ryood/Mixer/(list of files, cad)

Other CAD files:
case/Mixer-Case.dwg
