ryood/Mixer/eagle/Virtual-Ground.brd

## EAGLE design eagle/Virtual-Ground.brd (2014-09-16)

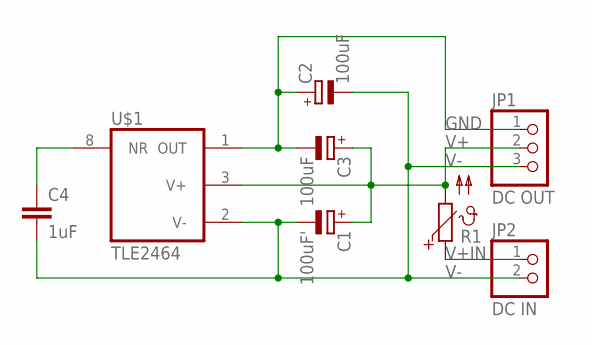
[picture p1: schematic Virtual-Ground.sch]

Parts:
C1: 100uF'; E2,5-6
C2, C3: 100uF; E2,5-6
C4: 1uF; C050-050X075
JP1: DC OUT; 1X03
JP2: DC IN; 1X02
R1: PTC660; P660
U$1: TLE2464

Connections:
GND: C2.+, C3.-, JP1.1, U$1.1 (OUT)
unnamed: C4.1, U$1.8 (NR)
V+: C1.+, C3.+, JP1.2, R1.2, U$1.3 (V+)
V+IN: JP2.1, R1.1
V-: C1.-, C2.-, C4.2, JP1.3, JP2.2, U$1.2 (V-)

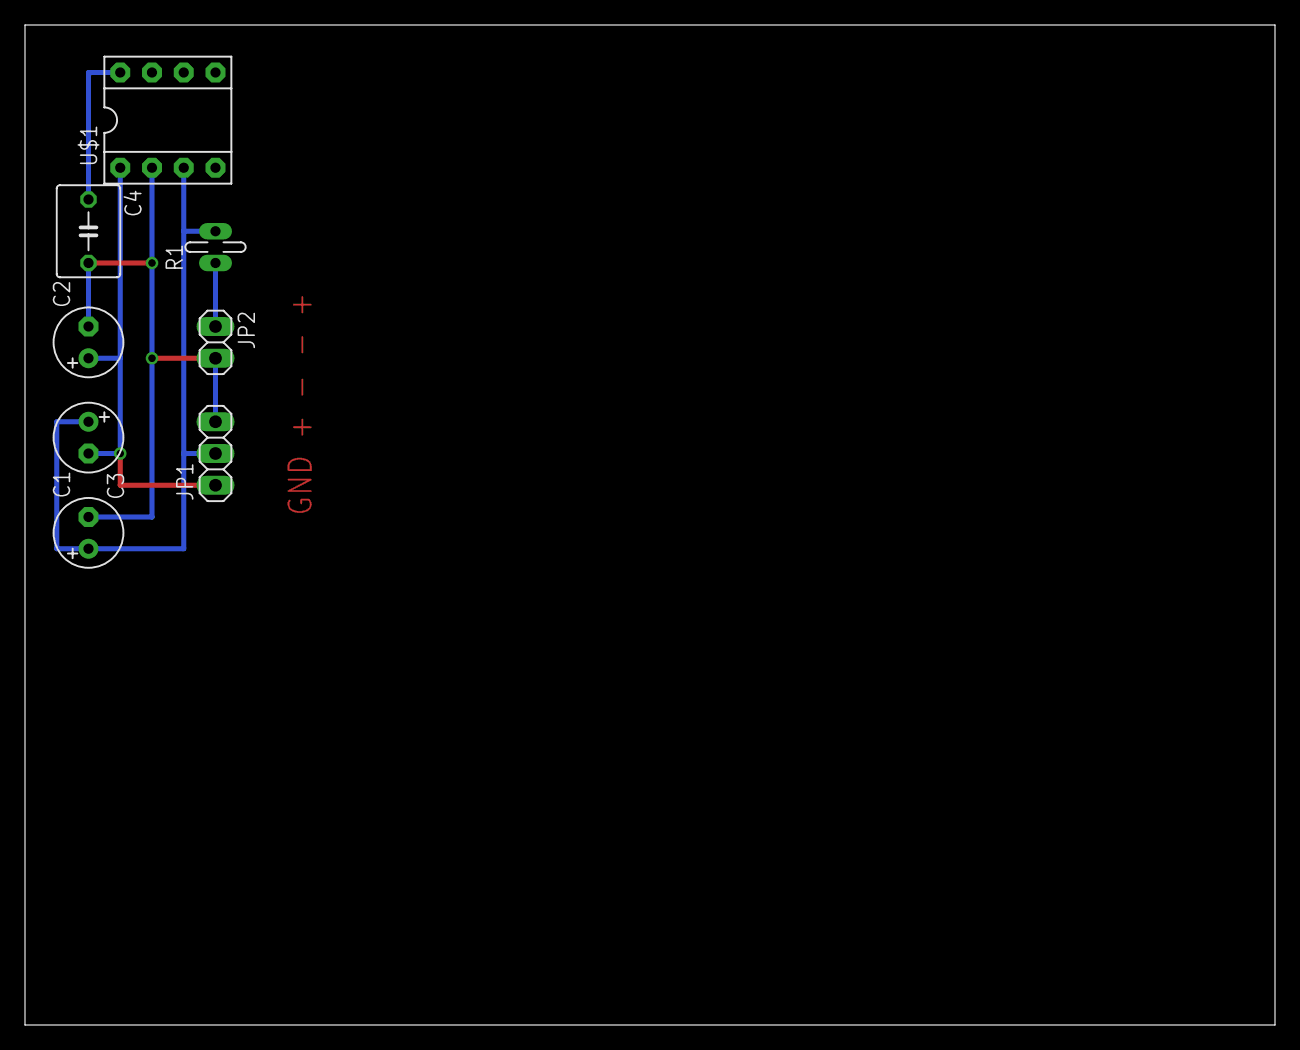
[picture p2: board Virtual-Ground.brd from above]

Board: 2 copper layers, 100.0 x 80.0 mm, 8 parts (0 on the bottom side), 5 nets.
