ryood/Mixer/eagle/Mixer-01.brd

## EAGLE design eagle/Mixer-01.brd (2014-09-14)

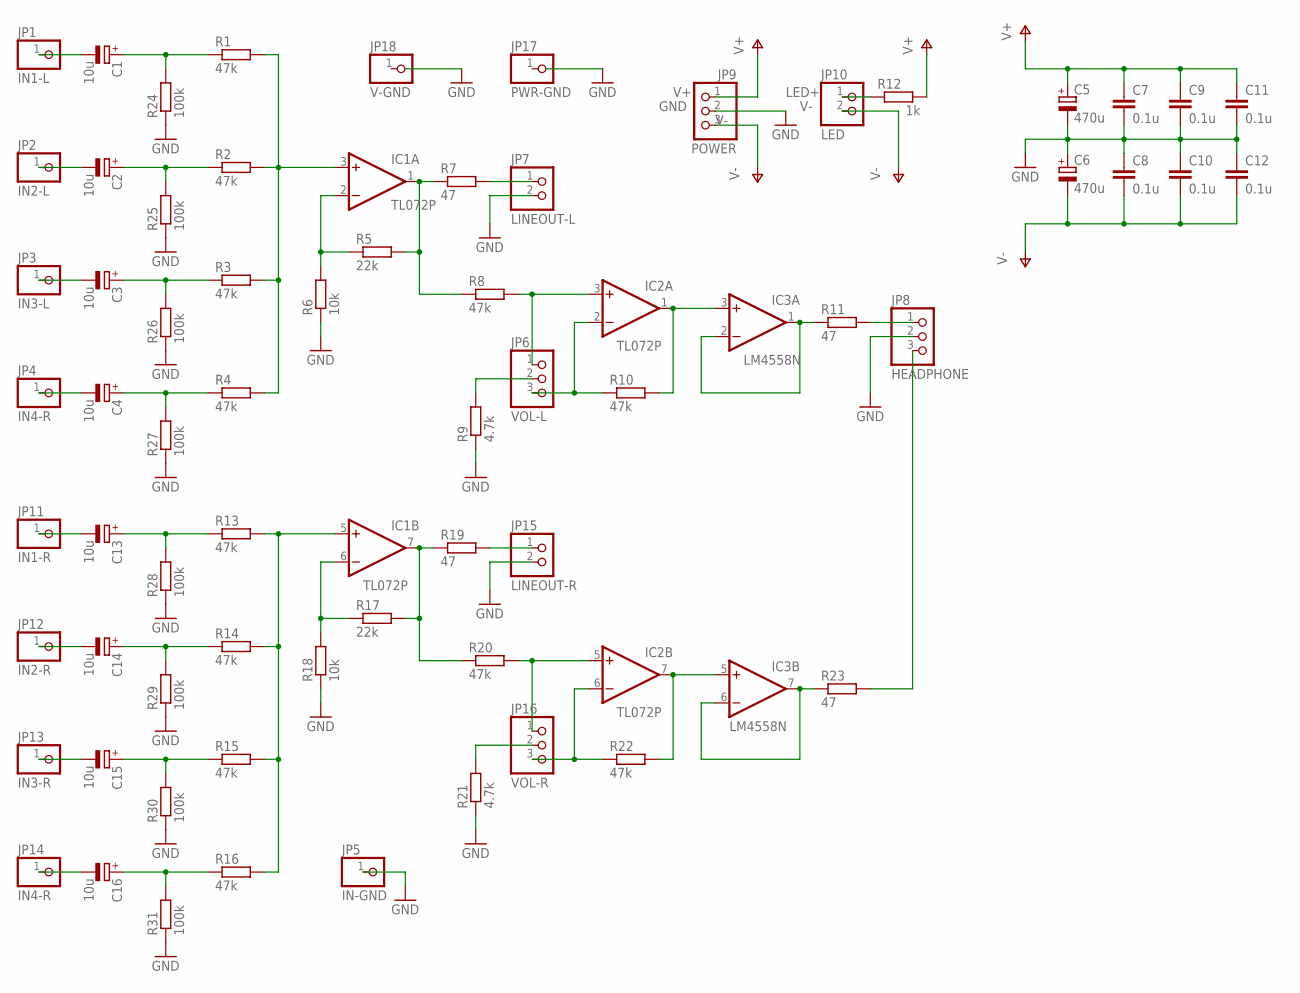
[picture p3: schematic Mixer-01.sch]

Parts:
C1, C2, C3, C4, C13, C14, C15, C16: 10u; E5-8,5
C5, C6: 470u; E7,5-16
C7, C8, C9, C10, C11, C12: 0.1u; C050-024X044
IC1, IC2: TL072P; DIL08
IC3: LM4558N; DIL08
JP1: IN1-L; 1X01
JP2: IN2-L; 1X01
JP3: IN3-L; 1X01
JP4, JP14: IN4-R; 1X01
JP5: IN-GND; 1X01
JP6: VOL-L; 1X03
JP7: LINEOUT-L; 1X02
JP8: HEADPHONE; 1X03
JP9: POWER; 1X03
JP10: LED; 1X02
JP11: IN1-R; 1X01
JP12: IN2-R; 1X01
JP13: IN3-R; 1X01
JP15: LINEOUT-R; 1X02
JP16: VOL-R; 1X03
JP17: PWR-GND; 1X01
JP18: V-GND; 1X01
R1, R2, R3, R4, R8, R10, R13, R14, R15, R16, R20, R22: 47k; 0207/7
R5, R17: 22k; 0207/7
R6, R18: 10k; 0207/7
R7, R11, R19, R23: 47; 0207/7
R9, R21: 4.7k; 0207/7
R12: 1k; 0207/7
R24, R25, R26, R27, R28, R29, R30, R31: 100k; 0207/7

Connections:
GND: C5.-, C6.+, C7.2, C8.1, C9.2, C10.1, C11.2, C12.1, JP5.1, JP7.2, JP8.2, JP9.2, JP15.2, R6.1, R9.1, R18.1, R21.1, R24.1, R25.1, R26.1, R27.1, R28.1, R29.1, R30.1, R31.1
LED+: JP10.1, R12.1
unnamed: C1.-, JP1.1
unnamed: C2.-, JP2.1
unnamed: C3.-, JP3.1
unnamed: C4.-, JP4.1
unnamed: JP6.2, R9.2
unnamed: C13.+, R13.1, R28.2
unnamed: C14.+, R14.1, R29.2
unnamed: C1.+, R1.1, R24.2
unnamed: C2.+, R2.1, R25.2
unnamed: C3.+, R3.1, R26.2
unnamed: C4.+, R4.1, R27.2
unnamed: IC1.3 (+IN), R1.2, R2.2, R3.2, R4.2
unnamed: IC1.2 (-IN), R5.1, R6.2
unnamed: IC1.1 (OUT), R5.2, R7.1, R8.1
unnamed: JP7.1, R7.2
unnamed: IC2.3 (+IN), JP6.1, R8.2
unnamed: C15.+, R15.1, R30.2
unnamed: IC2.2 (-IN), JP6.3, R10.1
unnamed: IC2.1 (OUT), IC3.3 (+IN), R10.2
unnamed: IC3.1 (OUT), IC3.2 (-IN), R11.1
unnamed: JP8.1, R11.2
unnamed: C16.+, R16.1, R31.2
unnamed: IC1.5 (+IN), R13.2, R14.2, R15.2, R16.2
unnamed: IC1.6 (-IN), R17.1, R18.2
unnamed: IC1.7 (OUT), R17.2, R19.1, R20.1
unnamed: JP15.1, R19.2
unnamed: IC2.5 (+IN), JP16.1, R20.2
unnamed: IC2.6 (-IN), JP16.3, R22.1
unnamed: IC2.7 (OUT), IC3.5 (+IN), R22.2
unnamed: IC3.6 (-IN), IC3.7 (OUT), R23.1
unnamed: JP8.3, R23.2
unnamed: C13.-, JP11.1
unnamed: C14.-, JP12.1
unnamed: C15.-, JP13.1
unnamed: C16.-, JP14.1
unnamed: JP16.2, R21.2
V+: C5.+, C7.1, C9.1, C11.1, IC1.8 (V+), IC2.8 (V+), IC3.8 (V+), JP9.1, R12.2
V-: C6.-, C8.2, C10.2, C12.2, IC1.4 (V-), IC2.4 (V-), IC3.4 (V-), JP9.3, JP10.2

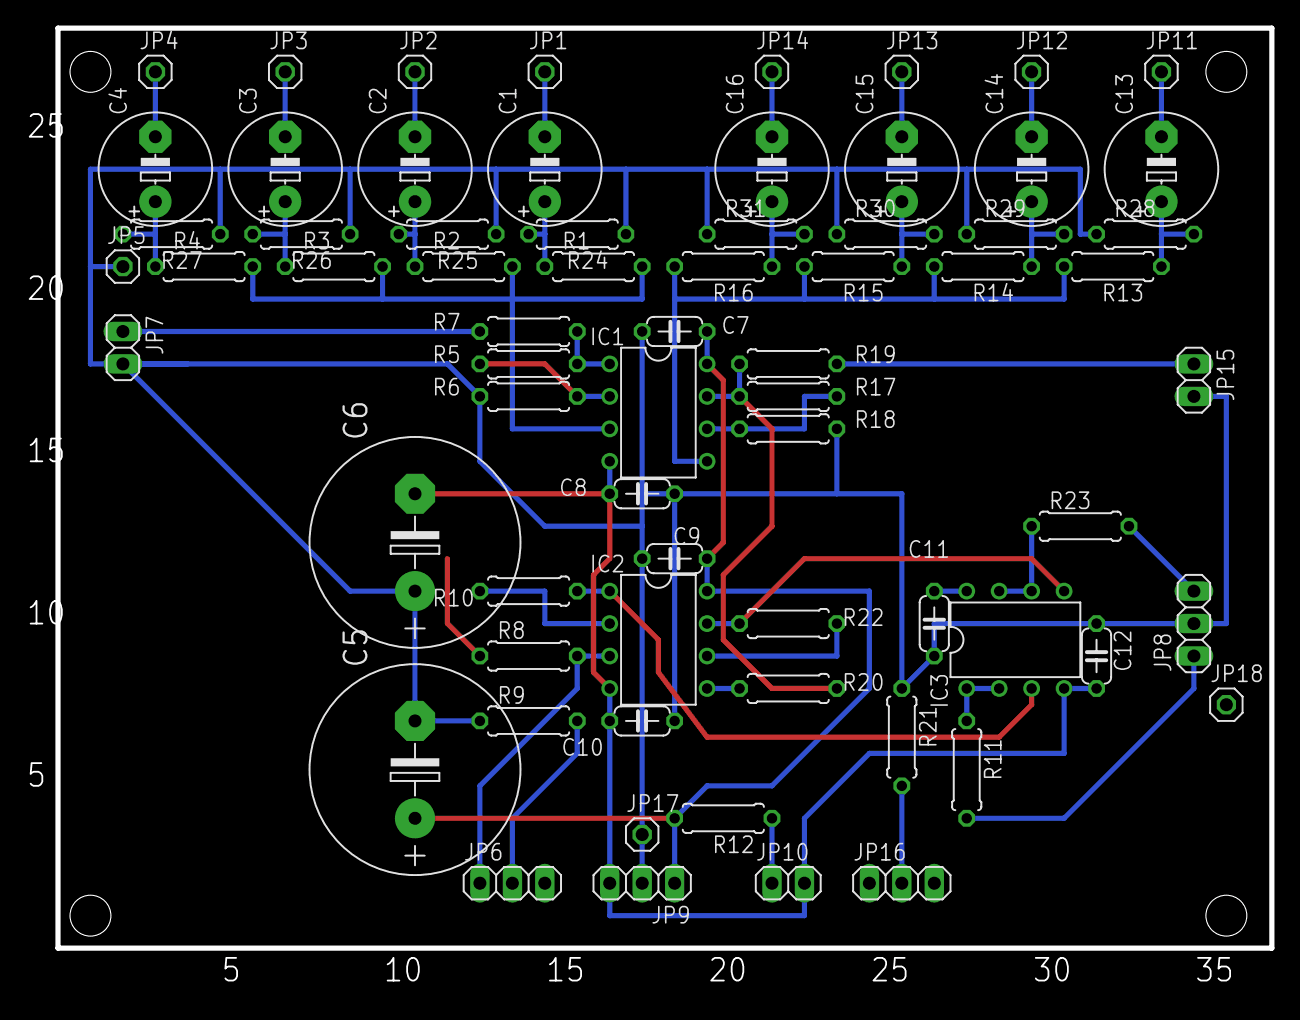
[picture p4: board Mixer-01.brd from above]

Board: 2 copper layers, 95.0 x 72.0 mm, 68 parts (0 on the bottom side), 40 nets.
