ryood/Mixer/TestChart.xlsx

Mixer テスト項目表
1. 電源なし
 | Point1 | Point2 | Check | 2014.07.09テスト | 2014.07.11テスト
1 | R1 | IC1 Pin3 | 47kΩ | 46.9k | ←
2 | R2 | IC1 Pin3 | 47kΩ | 47.0k | ←
3 | R3 | IC1 Pin3 | 47kΩ | 46.9k | ←
4 | R4 | IC1 Pin3 | 47kΩ | 47.0k | ←
5 | R13 | IC1 Pin5 | 47kΩ | 47.0k | ←
6 | R14 | IC1 Pin5 | 47kΩ | 47.1k | ←
7 | R15 | IC1 Pin5 | 47kΩ | 47.0k | ←
8 | R16 | IC1 Pin5 | 47kΩ | 47.0k | ←
9 | IN-GND | GND | 疎通 | ok | ←
10 | IC1 Pin2 | GND | 10kΩ | 10.01k | 10.02k
11 | IC1 Pin2 | IC1 Pin1 | 22kΩ | 21.7k | ←
12 | IC1 Pin1 | LINEOUT-L Pin1 | 47Ω | 47.2 | 47.0
13 | IC1 Pin1 | IC2 Pin3 | 47kΩ | 46.9k | ←
14 | LINEOUT-L Pin2 | GND | 疎通 | ok | ←
15 | IC2 Pin3 | VOL-L Pin1 | 疎通 | ok | ←
16 | IC2 Pin2 | VOL-L Pin3 | 疎通 | ok | ←
17 | VOL-L Pin2 | GND | 4.7kΩ | 4.68k | ←
18 | IC2 Pin1 | IC2 Pin2 | 47kΩ | 46.9k | ←
19 | IC2 Pin2 | VOL-L Pin3 | 疎通 | ok | ←
20 | IC2 Pin1 | IC3 Pin3 | 疎通 | ok | ←
21 | IC3 Pin2 | IC3 Pin1 | 疎通 | ok | ←
22 | IC１ Pin1 | HEADPHONE Pin1 | 47Ω | 47.3 | ←
23 | HEADPHONE Pin2 | GND | 疎通 | ok | ←
24 | IC1 Pin6 | GND | 10kΩ | 10.01k | ←
25 | IC1 Pin6 | IC1 Pin7 | 22kΩ | 21.8k | ←
26 | IC1 Pin7 | IC2 Pin5 | 47kΩ | 46.9k | ←
27 | IC1 Pin7 | LINEOUT-R Pin1 | 47Ω | 47.2 | 47.0
28 | LINEOUT-R Pin2 | GND | 疎通 | ok | ←
29 | IC2 Pin5 | VOL-R Pin1 | 疎通 | ok | ←
30 | IC2 Pin6 | VOL-R Pin3 | 疎通 | ok | ←
31 | VOL-R Pin2 | GND | 4.7kΩ | 4.7k | ←
32 | IC2 Pin6 | IC2 Pin7 | 47kΩ | 47.2k | ←
33 | IC2 Pin7 | IC3 Pin5 | 疎通 | ok | ←
34 | IC2 Pin6 | IC2 Pin7 | 47kΩ | 47.2k | ←
35 | IC2 Pin7 | IC3 Pin5 | 疎通 | ok | ←
36 | IC3 Pin6 | IC3 Pin7 | 疎通 | ok | ←
37 | IC3 Pin7 | HEADPHONE Pin3 | 47Ω | 47.2 | 47.3
38 | POWER Pin1 | IC1 Pin8 | 疎通 | ok | ←
39 | POWER Pin1 | IC2 Pin8 | 疎通 | ok | ←
40 | POWER Pin1 | IC3 Pin8 | 疎通 | NG | ok
41 | POWER Pin1 | LED Pin1 | 1kΩ | 994 | ←
42 | POWER Pin2 | GND | 疎通 | ? | ok
43 | POWER Pin3 | IC1 Pin4 | 疎通 | ok | ←
44 | POWER Pin3 | IC2 Pin4 | 疎通 | ok | ←
45 | POWER Pin3 | IC3 Pin4 | 疎通 | ok | ←
46 | POWER Pin3 | LED Pin2 | 疎通 | ok | ←
47 | PWR-GND | GND | 疎通 |  | ok
2.電源 -4.5V - 0V - +4.5V
 | Point1 | Point2 | Check | 2014.07.11 | 2014.07.18
1 | IC1 Pin4 | GND | -4.5V | -4.34 | -3.97
2 | IC1 Pin8 | GND | +4.5V | 4.47 | 4.22
3 | IC2 Pin4 | GND | -4.5V | -4.34 | -3.97
4 | IC2 Pin8 | GND | +4.5V | 4.47 | 4.22
5 | IC3 Pin4 | GND | -4.5V | -4.34 | -3.97
6 | IC3 Pin8 | GND | +4.5V | 4.47 | 4.22
7 | LED Pin1 | GND | +4.5V | 4.47 | 4.22
8 | LED Pin2 | GND | -4.5V | -4.34 | -3.97
3.電源 In1 0.45V Sine 1kHz
 | Point1 | Point2 | Check | 2014.07.13 | 2014.07.23
1 | V+ |  | 500uA | 12.28mA | 11mA to 37mA ※1
2 | V- |  | -500uA | -11.80mA | 12mA to 35mA ※1
3 | R1 | GND | DC 0V AC 0.45V | 1.26 0.35
4 | R13 | GND | DC 0V AC 0.45V | 2.36 0.301
5 | IC1 Pin3 | GND | DC 0V AC 0.45V | 1.243 0.140
6 | IC1 Pin5 | GND | DC 0V AC 0.45V | 2.30 0.119
7 | IC1 Pin2 | GND | DC 0V AC 0.45V | 1.061 0.140
8 | IC1 Pin6 | GND | DC 0V AC 0.45V | 2.28 0.001
9 | IC1 Pin1 | GND | DC 0V AC 1.45V | 3.26 0.324
10 | IC1 Pin7 | GND | DC 0V AC 1.45V | 3.57 0.001
※1 ヘッドホン出力なし to ヘッドホン出力MAX
