ryood/Mixer/(commit log)

2014-07-01 Mixer-01.brd 結線を修正
    [Mixer-01.brd, Mixer-01.sch]
2014-07-02 Mixer結線図.ai: 修正 Mixer-01.brd: 修正
    [Mixer-01.brd]
2014-07-02 Mixer-01.brd: グリッドを修正
    [Mixer-01.brd]
2014-07-04 Mixer-01.brd: 修正
    [Mixer-01.brd, Mixer-01.sch]
2014-07-05 TestChart.xlsx: 追加
    その他修正
    [Mixer-01.brd, TestChart.xlsx]
2014-07-10 電池ボックスのGNDの配線を変更
    [Mixer-01.brd, Mixer-01.sch]
2014-07-10 テストを結果記入
    [TestChart.xlsx]
2014-07-10 テスト結果追加
    [TestChart.xlsx]
2014-07-10 Mixer結線図 - テスト用.ai: 追加
2014-07-15 通電状態テスト項目追加
    [TestChart.xlsx]
2014-07-17 OPAMPの入力を接地
    [Mixer-01.brd, Mixer-01.sch, TestChart.xlsx]
2014-07-17 Mixer-01.brd: 配線を修正
    [Mixer-01.brd]
2014-07-20 結線図修正： GND線追加
2014-07-20 Mixer-Case.dwg: ケース加工図追加
    [Mixer-Case.dwg]
2014-07-22 ケース加工図修正
    [Mixer-Case.dwg, TestChart.xlsx]
2014-08-02 ケース加工図 Hole Size 修正
    [Mixer-Case.dwg]
2014-08-05 Mixer結線図修正 RCAジャックーPOTのGND線削除
2014-09-14 仮想グランド基板の設計図を追加
    [Virtual-Ground.brd, Virtual-Ground.sch]
2014-09-14 基板設計図修正
    [Virtual-Ground.brd]
2014-09-14 ケース加工図修正： 仮想グランド基板、DCジャック、電源切り替えスイッチ追加
    [Mixer-Case.dwg]
2014-09-14 Mixer結線図にV-GNDを追加 V-GND基板設計図を修正
    [Virtual-Ground.brd]
2014-09-14 Mixer基板設計図にV-GND用ピンを追加
    [Mixer-01.brd, Mixer-01.sch]
2014-09-16 Mixer結線図修正
2014-09-16 仮想グランド基板設計図修正
    [Virtual-Ground.brd]
